eSpark-Backup/simonlore-voiceassistant/README.md

# simonlore-voiceassistant
 This repo will hold all the hardware updates and design progress for the AI Assistant product

## Project Requirements
### User Interaction:
* Home Button: Central command button for basic device activation.
* Voice Recognition Trigger Button: Initiates voice recognition, ensuring user privacy and preventing unintended recordings.
* Rotary Selector: A combination of rotation and press functionality to enable users to navigate and select audio content or other features.

### Audio Interface:
* Input: Advanced voice recognition with three multidirectional microphones.
* Output: Jack port for headphones and Bluetooth audio capability for wireless connection.
* Volume Control: Potentiometer with integrated switch functionality to adjust audio levels.

### Connectivity:
* Wi-Fi Enabled: Facilitates online voice assistant capabilities and connectivity tasks.
* Bluetooth: Enables wireless audio output to headphones or compatible devices.

### Power Management:
* Battery Life: Built to last with up to 10 hours of offline usage and 3+ hours during connected operations.
* Charging Port: A durable USB-C interface (or an alternative based on cost considerations).

### Visual Indicators:
* Status LEDs: Indicators to display power, charging, and connectivity statuses.
* Interactive LEDs: Dynamic luminosity adjustments signal when the device is in listening or speaking mode.

### Operational Modes:
* Online Mode: Provides real-time voice assistance, interactive experiences, and internet-based functions.
* Offline Mode: Grants access to an array of preloaded audio content, ensuring usability without connectivity.

### Content and API Integration:
* Audio Recording: Equipped to record user voice inputs and relay them to an API for processing.
* Audio Playback: Ability to receive and audibly render content, inclusive of voice assistant feedback.
* External API Adaptability: Designed to interface with third-party APIs like Spotify, broadening content accessibility.

### Device Management:
* Remote App Control: A dedicated application to facilitate device setup, manage subscriptions, adjust parameters, and roll out firmware updates.
* Offline Content Administration: The same application enables users to curate offline content for the device.

### Design and Aesthetics:
* Robust Design: Crafted for durability without compromising on visual appeal.
* Safety Protocols: Built-in measures to regulate volume and content, ensuring user safety.

### Expandability and Updates:
* Future Adaptability: The software is designed for updates, ensuring the device remains contemporary with evolving tech trends.
* App-Driven Updates: Provides a user-friendly interface to update the device software and augment content.
