eSpark-Backup/simonlore-voiceassistant/Design-Files/Buttons-Board-v1.0/BOM/Client-BOM-Buttons-Board-v1.0.xlsx

 |  | Component list |  | Bill of Materials for Project [Buttons-Board-v1.0.]
 |  | Source Data From: |  | Buttons-Board-v1.0.
 |  | Project: |  | Buttons-Board-v1.0.
 |  | Variant: |  | None
# | Item Type | Designator | Description | Footprint | Manufacturer Part Number | Manufacturer | Value | Quantity | Quantity (5 Boards) | Remarks | Reviewer Remarks
1 | Capacitor | C1 | CAP CER 10UF 16V X5R 0603 | Cap-0603 | CC0603KRX5R7BB106 | Yageo | 10uF | 1 | 5
2 | Capacitor | C2 | CAP CER 0.1UF 16V X5R 0402 | Cap-0402 | CC0402KRX5R7BB104 | Yageo | 100nF | 1 | 5
3 | Diode | D1, D2, D3, D4, D5, D6, D7, D8, D9, D10, D11, D12 | DIODE GEN PURP 75V 150MA SOD323 | SOD-323 | 1N4148WS-7-F | Diodes | - | 12 | 60
4 | Board / Wire To Wire Connector | J1, J2, J3 | 1x9P 1 Tin 1mm male 9 260℃ -25℃~+85℃ Brass 1A Surface Mount SMD,P=1mm Wire To Board / Wire To Wire Connector ROHS | Custom | X1002WRS-09E-LPSWHF | XKB Connectivity | - | 3 | 15
5 | LED | LED1 | RED LED 0603 Light Emitting Diodes | LED-0603 | NCD0603R3 | Foshan NationStar Optoelectronics | - | 1 | 5
6 | LED | LED2, LED3, LED4, LED5, LED6, LED7, LED8, LED9, LED10, LED11, LED12, LED13, LED14, LED15, LED16, LED17 | blue 0603 Light Emitting Diodes (LED) ROHS | LED-0603 | NCD0603B3 | Foshan NationStar Optoelectronics | - | 16 | 80
7 | Resistor | R1 | RES 1K OHM 1% 1/16W 0402 | Res-0402 | RC0402FR-071KL | Yageo | 1K | 1 | 5
8 | Resistor | R2, R3, R4, R5, R6, R7, R8, R9, R10, R11, R12, R13, R14, R15, R16, R17 | RES 33 OHM 1% 1/20W 0201 | Res-0201 | RC0201FR-0733RL | Yageo | 33R | 16 | 80
9 | Tactile Switch | SW1 | SWITCH TACTILE SPST-NO 0.05A 12V | Custom | TL3300CF160Q | E-Switch | - | 1 | 5
10 | Tactile Switch | SW2, SW3, SW4, SW5, SW6, SW7, SW8, SW9, SW10, SW11, SW12, SW13 | No NO 50mA 100000 Times 160gf 12V Brick nogging SPST SMD Tactile Switches ROHS | Custom | TS-1109S-B-B | XKB Connectivity | - | 12 | 60
