eSpark-Backup/simonlore-voiceassistant/Design-Files/Buttons-Board-v1.0/BOM/eSpark-BOM-Buttons-Board-v1.0.xlsx

 |  | Component list |  | Bill of Materials for Project [Buttons-Board-v1.0.]
 |  | Source Data From: |  | Buttons-Board-v1.0.
 |  | Project: |  | Buttons-Board-v1.0.
 |  | Variant: |  | None
# | Item Type | Designator | Description | Footprint | Manufacturer Part Number | Manufacturer | Alternate Part Number | LCSC Part Number | Value | Quantity | Quantity (5 Boards) | MOQ (5 Boards) | Links | Unit Cost (5 Boards) | Total Cost (5 Boards) | Remarks | Reviewer Remarks
1 | Capacitor | C1 | CAP CER 10UF 16V X5R 0603 | Cap-0603 | CC0603KRX5R7BB106 | Yageo | - | C2936601 | 10uF | 1 | 5 | 10 | LCSC (https://www.lcsc.com/product-detail/Multilayer-Ceramic-Capacitors-MLCC-SMD-SMT_YAGEO-CC0603KRX5R7BB106_C2936601.html) | $0.1372 | $1.3720
2 | Capacitor | C2 | CAP CER 0.1UF 16V X5R 0402 | Cap-0402 | CC0402KRX5R7BB104 | Yageo | - | C106204 | 100nF | 1 | 5 | 100 | LCSC (https://www.lcsc.com/product-detail/Multilayer-Ceramic-Capacitors-MLCC-SMD-SMT_YAGEO-CC0402KRX5R7BB104_C106204.html) | $0.0011 | $0.1100
3 | Diode | D1, D2, D3, D4, D5, D6, D7, D8, D9, D10, D11, D12 | DIODE GEN PURP 75V 150MA SOD323 | SOD-323 | 1N4148WS-7-F | Diodes | - | C60580 | - | 12 | 60 | 100 | LCSC (https://www.lcsc.com/product-detail/Switching-Diode_Diodes-Incorporated-1N4148WS-7-F_C60580.html) | $0.0128 | $1.2800
4 | Board / Wire To Wire Connector | J1, J2, J3 | 1x9P 1 Tin 1mm male 9 260℃ -25℃~+85℃ Brass 1A Surface Mount SMD,P=1mm Wire To Board / Wire To Wire Connector ROHS | Custom | X1002WRS-09E-LPSWHF | XKB Connectivity | - | C437069 | - | 3 | 15 | 20 | LCSC (https://www.lcsc.com/product-detail/Wire-To-Board-Wire-To-Wire-Connector_XKB-Connectivity-X1002WRS-09E-LPSWHF_C437069.html) | $0.1150 | $2.3000
5 | LED | LED1 | RED LED 0603 Light Emitting Diodes | LED-0603 | NCD0603R3 | Foshan NationStar Optoelectronics | - | C3151730 | - | 1 | 5 | 20 | LCSC (https://www.lcsc.com/product-detail/Light-Emitting-Diodes-LED_Foshan-NationStar-Optoelectronics-NCD0603R3_C3151730.html) | $0.0208 | $0.4160
6 | LED | LED2, LED3, LED4, LED5, LED6, LED7, LED8, LED9, LED10, LED11, LED12, LED13, LED14, LED15, LED16, LED17 | blue 0603 Light Emitting Diodes (LED) ROHS | LED-0603 | NCD0603B3 | Foshan NationStar Optoelectronics | - | C158101 | - | 16 | 80 | 100 | LCSC (https://www.lcsc.com/product-detail/Light-Emitting-Diodes-LED_Foshan-NationStar-Optoelectronics-NCD0603B3_C158101.html) | $0.0313 | $3.1300
7 | Resistor | R1 | RES 1K OHM 1% 1/16W 0402 | Res-0402 | RC0402FR-071KL | Yageo | - | C106235 | 1K | 1 | 5 | 100 | LCSC (https://www.lcsc.com/product-detail/Chip-Resistor-Surface-Mount_YAGEO-RC0402FR-071KL_C106235.html) | $0.0007 | $0.0700
8 | Resistor | R2, R3, R4, R5, R6, R7, R8, R9, R10, R11, R12, R13, R14, R15, R16, R17 | RES 33 OHM 1% 1/20W 0201 | Res-0201 | RC0201FR-0733RL | Yageo | - | C295794 | 33R | 16 | 80 | 100 | LCSC (https://www.lcsc.com/product-detail/Chip-Resistor-Surface-Mount_YAGEO-RC0201FR-0733RL_C295794.html) | $0.0009 | $0.0900
9 | Tactile Switch | SW1 | SWITCH TACTILE SPST-NO 0.05A 12V | Custom | TL3300CF160Q | E-Switch | - | C273516 | - | 1 | 5 | 6 | LCSC (https://www.lcsc.com/product-detail/Tactile-Switches_E-Switch-TL3300CF160Q_C273516.html) | $0.4604 | $2.7624
10 | Tactile Switch | SW2, SW3, SW4, SW5, SW6, SW7, SW8, SW9, SW10, SW11, SW12, SW13 | No NO 50mA 100000 Times 160gf 12V Brick nogging SPST SMD Tactile Switches ROHS | Custom | TS-1109S-B-B | XKB Connectivity | - | C480315 | - | 12 | 60 | 80 | LCSC (https://www.lcsc.com/product-detail/Tactile-Switches_XKB-Connectivity-TS-1109S-C-B_C381037.html) | $0.0217 | $1.7360
 |  |  |  |  |  |  |  |  |  |  |  | Total Component Cost |  |  | $13.27
 |  |  |  |  |  |  |  |  |  |  |  | Single Board Cost |  |  | $2.65
