eSpark-Backup/simonlore-voiceassistant/Design-Files/Main-Board-v1.0/BOM/Client-BOM-Main-Board-v1.0.xlsx

 |  | Component list |  | Bill of Materials for Project [Main-Board-v1.0.]
 |  | Source Data From: |  | Main-Board-v1.0.
 |  | Project: |  | Main-Board-v1.0.
 |  | Variant: |  | None
# | Item Type | Designator | Description | Footprint | Manufacturer Part Number | Manufacturer | Value | Quantity | Quantity (5 Boards) | Links | Remarks | Reviewer Remarks
1 | Capacitor | C1, C7, C8, C11, C12, C13, C16, C17, C59, C60, C69, C70, C81, C89, C92 | CAP CER 10UF 16V X5R 0603 | Cap-0603 | CC0603KRX5R7BB106 | Yageo | 10uF | 15 | 75
2 | Capacitor | C2 | CAP CER 10000PF 50V C0G/NPO 0603 | Cap-0603 | CC0603JRNPO9BN103 | Yageo | 10nF | 1 | 5
3 | Capacitor | C3, C19, C20, C51, C52 | CAP CER 22UF 16V X5R 0805 | Cap-0805 | CL21A226MOCLRNC | Samsung | 22uF | 5 | 25
4 | Capacitor |  | CAP CER 0.1UF 16V X5R 0402 | Cap-0402 | CC0402KRX5R7BB104 | Yageo | 100nF | 39 | 195
5 | Capacitor | C6 | CAP CER 22UF 10V X5R 0603 | Cap-0603 | CC0603MRX5R6BB226 | Yageo | 22uF | 1 | 5
6 | Capacitor | C10, C22 | CAP TANT 100UF 20% 25V 2917 | Case-E | TAJE107M025RNJ | Kyocera AVX | 100uF | 2 | 10
7 | Capacitor | C18 | CAP CER 4700PF 1KV X7R 1206 | Cap-1206 | CC1206KKX7RCBB472 | Yageo | 4.7nF | 1 | 5
8 | Capacitor | C42, C43 | CAP CER 18PF 50V C0G/NPO 0603 | Cap-0603 | CC0603JRNPO9BN180 | Yageo | 18pF | 2 | 10
9 | Capacitor | C45, C47, C48, C49, C50, C61, C62, C67, C68, C83, C84, C85, C93 | CAP CER 1UF 25V X5R 0402 | Cap-0402 | CC0402KRX5R8BB105 | Yageo | 1uF | 13 | 65
10 | Capacitor | C55, C56, C79, C80 | CAP CER 39PF 50V C0G/NPO 0402 | Cap-0402 | CC0402FRNPO9BN390 | Yageo | 39pF | 4 | 20
11 | Capacitor | C57, C58, C71, C72 | 470uF 16V ±20% SMD,D6.3xL7.7mm Aluminum Electrolytic Capacitors - SMD ROHS | Custom | RVT1C471M0607 | ROQANG | 470uF | 4 | 20
12 | Capacitor | C63, C64 | CAP CER 1000PF 25V C0G/NPO 0603 | CAP-0603 | CC0603JRNPO8BN102 | Yageo | 1nF | 2 | 10
13 | Capacitor | C65, C66 | CAP CER 3300PF 50V C0G/NPO 0603 | Cap-0603 | CC0603JRNPO9BN332 | Yageo | 3.3nF | 2 | 10
14 | Capacitor | C75, C76, C77, C78 | CAP CER 330PF 50V C0G/NPO 0603 | Cap-0603 | CC0603JRNPO9BN331 | Yageo | 330pF | 4 | 20
15 | Capacitor | C95 | CAP CER 0.22UF 25V X5R 0402 | Cap-0402 | CC0402KRX5R8BB224 | Yageo | 220nF | 1 | 5
16 | Diode | D1 | SOD-523 ESD Protection Devices ROHS | SOD-523 | LESD5D5.0CT1G | UMW | - | 1 | 5
17 | Diode | D2 | DIODE SCHOTTKY 40V 1A SOD123 | SOD-123 | 1N5819HW-7-F | Diodes | - | 1 | 5
18 | Diode | D3, D4 | 0.5mA@40V 40V Single 3A 0.55V@3A SMA(DO-214AC) Schottky Barrier Diodes (SBD) ROHS | SMA | SS34 | MDD | - | 2 | 10
19 | Diode | D5, D6, D7, D8, D9, D10, D11 | 5V 10V 3.3V Bi-Directional SOD-882 ESD Protection Devices ROHS | SOD-882 | LESD8D3.3CAT5G | LRC | - | 7 | 35
20 | Ferrite Bead | FB1, FB3, FB4, FB5, FB6, FB7, FB8, FB9, FB10 | FERRITE BEAD 120 OHM 0603 1LN | IND-0603 (1608 Metric) | BLM18SG121TZ1D | Murata | - | 9 | 45
21 | Ferrite Bead | FB2 | FERRITE BEAD 120 OHM 1206 1LN | IND-1206 | BLM31KN121SZ1L | Murata | - | 1 | 5
22 | USB Connector | J1 | USB 3.1 1 Surface Mount 6 Female -25℃~+85℃ Type-C SMD USB Connectors ROHS | Custom | U262-061N-4BVC11 | XKB | - | 1 | 5
23 | Right Angle JST | J2, J6, J7 | 1x2P 1 2mm Male pin 2 -25℃~+85℃ 2A Surface Mount SMD,P=2mm Wire To Board / Wire To Wire Connector ROHS | Custom | WAFER-PH2.0-2PWB | XUNPU | - | 3 | 15
24 | Connector | J3 | 1x6P SH 1 1mm 6 SMD,P=1mm Wire To Board / Wire To Wire Connector ROHS | Custom | C145963 | BOOMELE | - | 1 | 5
25 | Male Header | J4 | Gold 250V 3A Straight Square Pins 2.5mm 2P 260℃ 6mm -40℃~+105℃ 3mm 2.54mm Plugin Black Brass 1x2P Plugin,P=2.54mm Pin Headers ROHS | Custom | X6511WV-02H-C60D30 | XKB | - | 1 | 5
26 | Connector | J5 | -20℃~+70℃ 3.5mm headphone jack 235℃ 12V 0.5A SMD Audio Connectors ROHS | Custom | PJ-342B-TX-SMT | XKB Connectivity | - | 1 | 5
27 | SD Card Connector | J8 | CONN MICRO SD CARD PUSH-PUSH R/A | Custom | DM3BT-DSF-PEJS | Hirose | - | 1 | 5
28 | Board / Wire To Wire Connector | J9, J10, J11 | 1x9P 1 Tin 1mm male 9 260℃ -25℃~+85℃ Brass 1A Surface Mount SMD,P=1mm Wire To Board / Wire To Wire Connector ROHS | Custom | X1002WRS-09E-LPSWHF | XKB Connectivity | - | 3 | 15
29 | Inductor | L1, L2, L3 | 4.5A 4.7uH ±20% SMD,10.1x10.1mm Power Inductors ROHS | Custom | YSLF1045-4R7M | YJYCOIN | 4.7uH | 3 | 15
30 | Inductor | L4, L5, L6, L7 | 3.6A 33uH Shielded Power Inductors ±20% 4.25A SMD,12.5x12.5mm Power Inductors ROHS | Custom | SMDRI129-330MT | SXN | 33uH | 4 | 20
31 | LED | LED1, LED3 | RED LED 0603 Light Emitting Diodes | LED-0603 | NCD0603R3 | Foshan NationStar Optoelectronics | - | 2 | 10
32 | LED | LED2 | Emerald 0603 Light Emitting Diodes (LED) ROHS | LED-0603 | NCD0603G2 | Foshan NationStar Optoelectronics | - | 1 | 5
33 | TEST POINT | ~~P1, P2, P3, P4, P5, P6, P7, P8, P9, P10, P11, P12, P13, P14, P15, P16, P17, P18, P19, P20, P21, P22, P23, P24, P25, P26, P27~~ | ~~Test Point ON~~ | ~~Custom~~ | ~~Test-point~~ | ~~-~~ | ~~-~~ | ~~27~~ | ~~135~~
34 | MOSFET | Q1, Q2 | MOSFET P-CH 12V 16A 8SO | SOP-8 | IRF7410TRPBF | Infineon | - | 2 | 10
35 | MOSFET | Q3 | 25V 300mW 120@100mA,1V 1.5A NPN SOT-23 Bipolar Transistors - BJT ROHS | SOT-23 | SS8050-G | Jiangsu Changjing Electronics Technology | - | 1 | 5
36 | MOSFET | Q4, Q5 | 50V 0.2A 225mW 3.5Ω@5V,200mA N Channel SOT-23 MOSFETs ROHS | SOT-23 | LBSS138LT1G | LRC | - | 2 | 10
37 | Resistor | R1, R2, R28, R36, R72, R73, R74, R89, R90, R91, R92, R148 | RES 100K OHM 1% 1/16W 0402 | Res-0402 | RC0402FR-07100KL | Yageo | 100K | 12 | 60
38 | Resistor | R3 | 2W Thick Film Resistors ±200ppm/℃ ±1% 0Ω 2512 Chip Resistor - Surface Mount ROHS | RES-2512 | FRP2512F0000TS | FOJAN | 0R | 1 | 5
39 | Resistor | R4, R6, R7, R15, R16, R26, R27, R31, R38, R66, R68, R69, R70, R71, R129, R130, R131, R132, R133, R134, R135, R137, R139, R144, R145 | RES 10K OHM 1% 1/16W 0402 | Res-0402 | RC0402FR-0710KL | Yageo | 10K | 25 | 125
40 | Resistor | R5, R17 | RES 0 OHM JUMPER 1/16W 0402 | Res-0402 | RC0402FR-070RL | Yageo | 0R | 2 | 10
41 | Resistor | R8, R18, R146 | RES SMD 52.3KOHM 0.1% 1/16W 0402 | Res-0402 | RT0402BRD0752K3L | Yageo | 52.3K | 3 | 15
42 | Resistor | R9, R19, R147 | RES SMD 30.1KOHM 0.1% 1/16W 0402 | Res-0402 | RT0402BRD0730K1L | Yageo | 30.1K | 3 | 15
43 | Resistor | R10, R23, R29, R39, R40 | RES 1K OHM 1% 1/16W 0402 | Res-0402 | RC0402FR-071KL | Yageo | 1K | 5 | 25
44 | Resistor | R11, R12, R13, R14 | RES 0 OHM JUMPER 1/8W 0805 | Res-0805 | RC0805FR-070RL | Yageo | 0R | 4 | 20
45 | Resistor | R20, R21 | RES 5.1K OHM 1% 1/16W 0402 | Res-0402 | RC0402FR-075K1L | Yageo | 5.1K | 2 | 10
46 | Resistor | R22 | RES SMD 1M OHM 1% 1/10W 0603 | Res-0603 | RC0603FR-071ML | Yageo | 1M | 1 | 5
47 | Resistor | R24 | RES SMD 316 OHM 0.1% 1/8W 0805 | RES-0805 | RT0805BRD07316RL | Yageo | 316R | 1 | 5
48 | Resistor | R25 | RES 1K OHM 1% 1/8W 0805 | RES-0805 | RC0805FR-071KL | Yageo | 1K | 1 | 5
49 | Resistor | R30, R32, R33, R34, R37, R41, R42, R43, R44, R45, R46, R47, R48, R49, R50, R51, R52, R53, R54, R55, R56, R57, R58, R59, R60, R61, R62, R63, R64, R65, R67 | RES SMD 0 OHM JUMPER 1/20W 0201 | Res-0201 | RC0201JR-070RL | Yageo | 0R | 31 | 155
50 | Resistor | R35, R112, R113, R114, R116 | RES 0 OHM JUMPER 1/10W 0603 | Res-0603 | RC0603JR-070RL | Yageo | 0R | 5 | 25
51 | Resistor | R75, R76, R77, R78, R79, R80, R81, R82, R83, R84, R85, R86, R87, R88, R93, R94, R95, R96, R97, R98, R99, R100, R101, R102, R103, R104, R105, R106, R107, R108, R136, R138, R140, R141, R142, R143 | RES 33 OHM 1% 1/20W 0201 | Res-0201 | RC0201FR-0733RL | Yageo | 33R | 36 | 180
52 | Resistor | R109 | RES 3.3K OHM 1% 1/20W 0201 | Res-0201 | RC0201FR-073K3L | Yageo | 3.3K | 1 | 5
53 | Resistor | R110, R111 | RES 56K OHM 1% 1/16W 0402 | Res-0402 | RC0402FR-0756KL | Yageo | 56k | 2 | 10
54 | Resistor | R115 | RES 22.1K OHM 1% 1/10W 0603 | Res-0603 | RC0603FR-0722K1L | Yageo | 22.1K | 1 | 5
55 | Resistor | R117, R128 | RES 1K OHM 1% 1/16W 0402 | Res-0402 | RC0402FR-071KL | Yageo | DNP | 2 | 10 |  | DO NOT Place
56 | Resistor | R118, R119 | RES 1 OHM 1% 1/10W 0603 | Res-0603 | RC0603FR-071RL | Yageo | 1R | 2 | 10
57 | Resistor | R120 | RES SMD 18K OHM 0.1% 1/16W 0402 | Res-0402 | RT0402BRD0718KL | Yageo | 18K | 1 | 5
58 | Resistor | R121 | RES SMD 28K OHM 0.1% 1/16W 0402 | Res-0402 | RT0402BRD0728KL | Yageo | 28K | 1 | 5
59 | Resistor | R122, R124 | RES SMD 510K OHM 0.1% 1/10W 0603 | Res-0603 | RT0603BRD07510KL | Yageo | 510K | 2 | 10
60 | Resistor | R123, R125 | RES SMD 110K OHM 0.1% 1/10W 0603 | Res-0603 | RT0603BRE07110KL | Yageo | 110K | 2 | 10
61 | Resistor | R126, R127 | RES 30K OHM 1% 1/16W 0402 | Res-0402 | RC0402FR-0730KL | Yageo | 30K | 2 | 10
62 | Solder Bridge | SB1 | Solder Bridge ON | Custom | Solder Bridge 0402 | - | - | 1 | 5 |  | DO NOT Place
63 | Switch | SW1, SW2 | No NO 50mA 4.5mm 100000 260gf 12V -30℃~+85℃ 4.5mm 4.3mm Black Round Button Brick nogging SPST SMD Tactile Switches ROHS | Custom | TS-1109S-C-B | XKB Connectivity | - | 2 | 10
64 | IC | U1 | IC REG LINEAR 3.3V 1A SOT223-6 | SOT-223-6_ | TPS79633DCQR | Texas Instruments | - | 1 | 5
65 | IC | U2 | IC CNTRLR ON/OFF W/DEB TSOT23-6 | TSOT-23-6 | MAX16054AZT+T | Maxim | - | 1 | 5
66 | IC | U3, U4, U5, U16 | IC REG LIN POS ADJ 400MA SOT23-5 | SOT-23-5 | TPS73601DBVR | Texas Instruments | - | 4 | 20
67 | IC | U6 | 4V~6V Polymer 1 3.5A SOP-8-EP Battery Management ICs ROHS | 8-SO-EP_ | SLM6600 | SOLA-IC | - | 1 | 5
68 | IC | U7 | IC SUPERVISOR 1 CHANNEL SOT23-3 | SOT-23 | CAT809RTBI-GT3 | ON Semiconductor | - | 1 | 5
69 | Module | U8 | RF TXRX MODULE BT PCB TRACE SMD | 38-SMD Module | ESP32-WROVER-E-N16R8 | Espressif Systems | - | 1 | 5
70 | IC | U9 | IC AUDIO SIGNAL PROCESSOR 64QFN | QFN-64-EP(9x9) | ZL38063LDG1 | Microchip | - | 1 | 5
71 | IC | U10 | IC FLASH 16MBIT SPI/QUAD 8SOIC | SOP-8 | W25Q16JVSNIQ | Winbond | - | 1 | 5
72 | IC | U11, U12 | SOP8L-PP Audio Power OpAmps ROHS | 8-SO-EP_ | HT8691RSPER | Jiaxing Heroic Elec Tech | - | 2 | 10
73 | Microphone | U13, U14, U15 | MIC MEMS DIGITAL PDM OMNI -26DB | Custom | MP34DT06JTR | STMicroelectronics | - | 3 | 15
74 | IC | U17 | IC XPNDR 100KHZ I2C 20TSSOP | TSSOP-20 | PCF8574APWR | Texas Instruments | - | 1 | 5
75 | IC | U18 | IC LED DRVR LIN PWM 20MA 28QFN | QFN-28-EP(4x4) | IS31FL3216A-QFLS3-TR | ISSI | - | 1 | 5
76 | Crystal | X1 | 12MHz 18pF ±10ppm SMD2520-4P Crystals ROHS | Custom | 2TJ412000XYGBC | JYJE | 12MHz | 1 | 5
77 | Peripheral | - | Polymer lithium battery, 906090 mobile power charging treasure | - | Battery | - | - | 1 | 5 | Aliexpress (https://vi.aliexpress.com/item/32824237225.html?gatewayAdapt=glo2vnm)
78 | Peripheral |  |  |  | Speaker
