eSpark-Backup/simonlore-voiceassistant/Design-Files/Main-Board-v1.0/Main-Board-v1.0.pdf

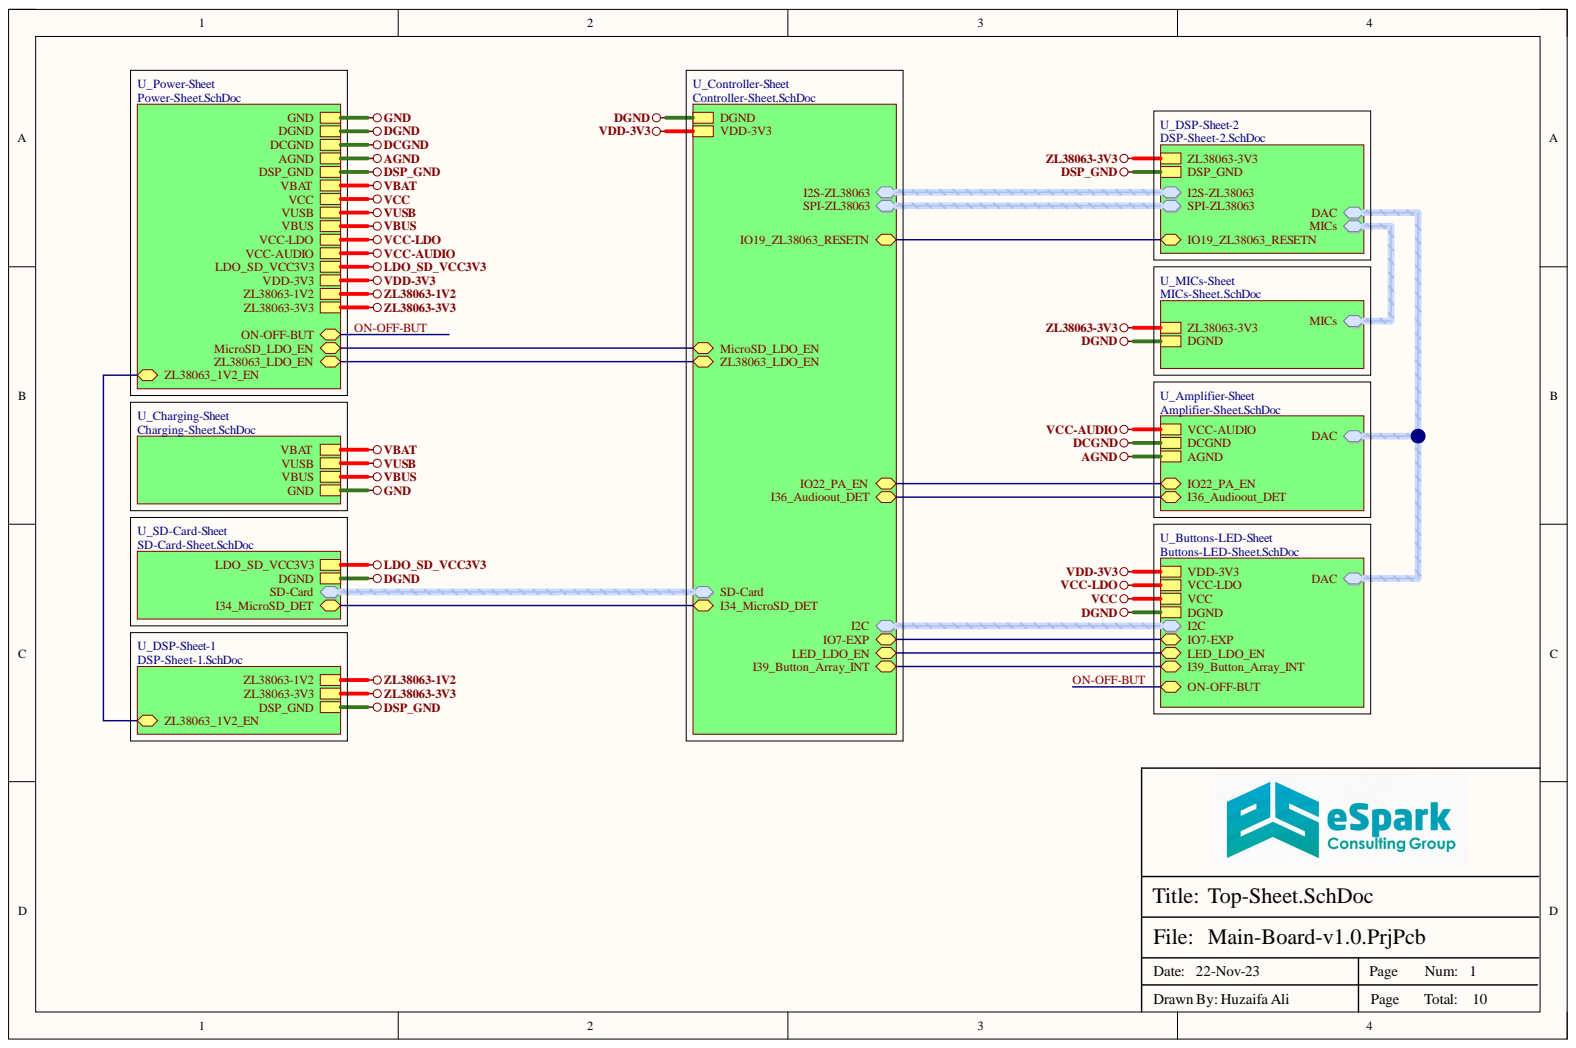
[picture p1: page 1]

U_SD-Card-Sheet
SD-Card-Sheet.SchDoc

Date: 22-Nov-23 | Page Num: 1

Drawn By: Huzaifa Ali | Page Total: 10

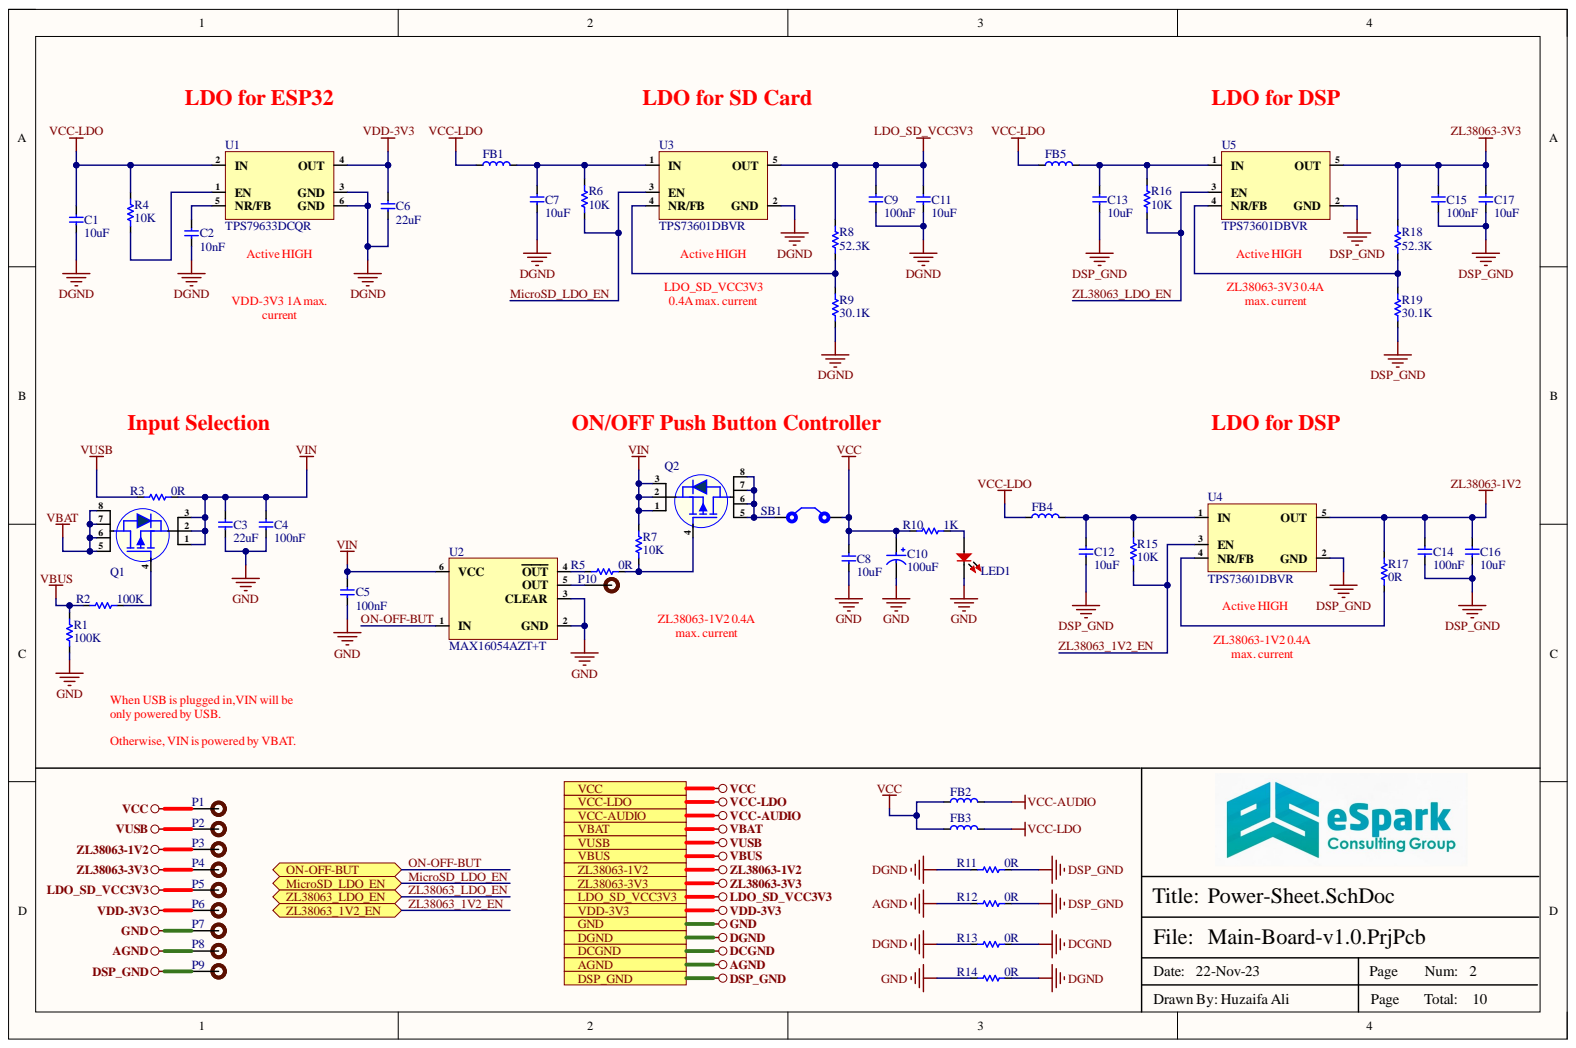
[picture p2: page 2]

LDO for SD Card

When USB is plugged in,VIN will be
only powered by USB.

Otherwise, VIN is powered by VBAT.

Date: 22-Nov-23 | Page Num: 2

Drawn By: Huzaifa Ali | Page Total: 10

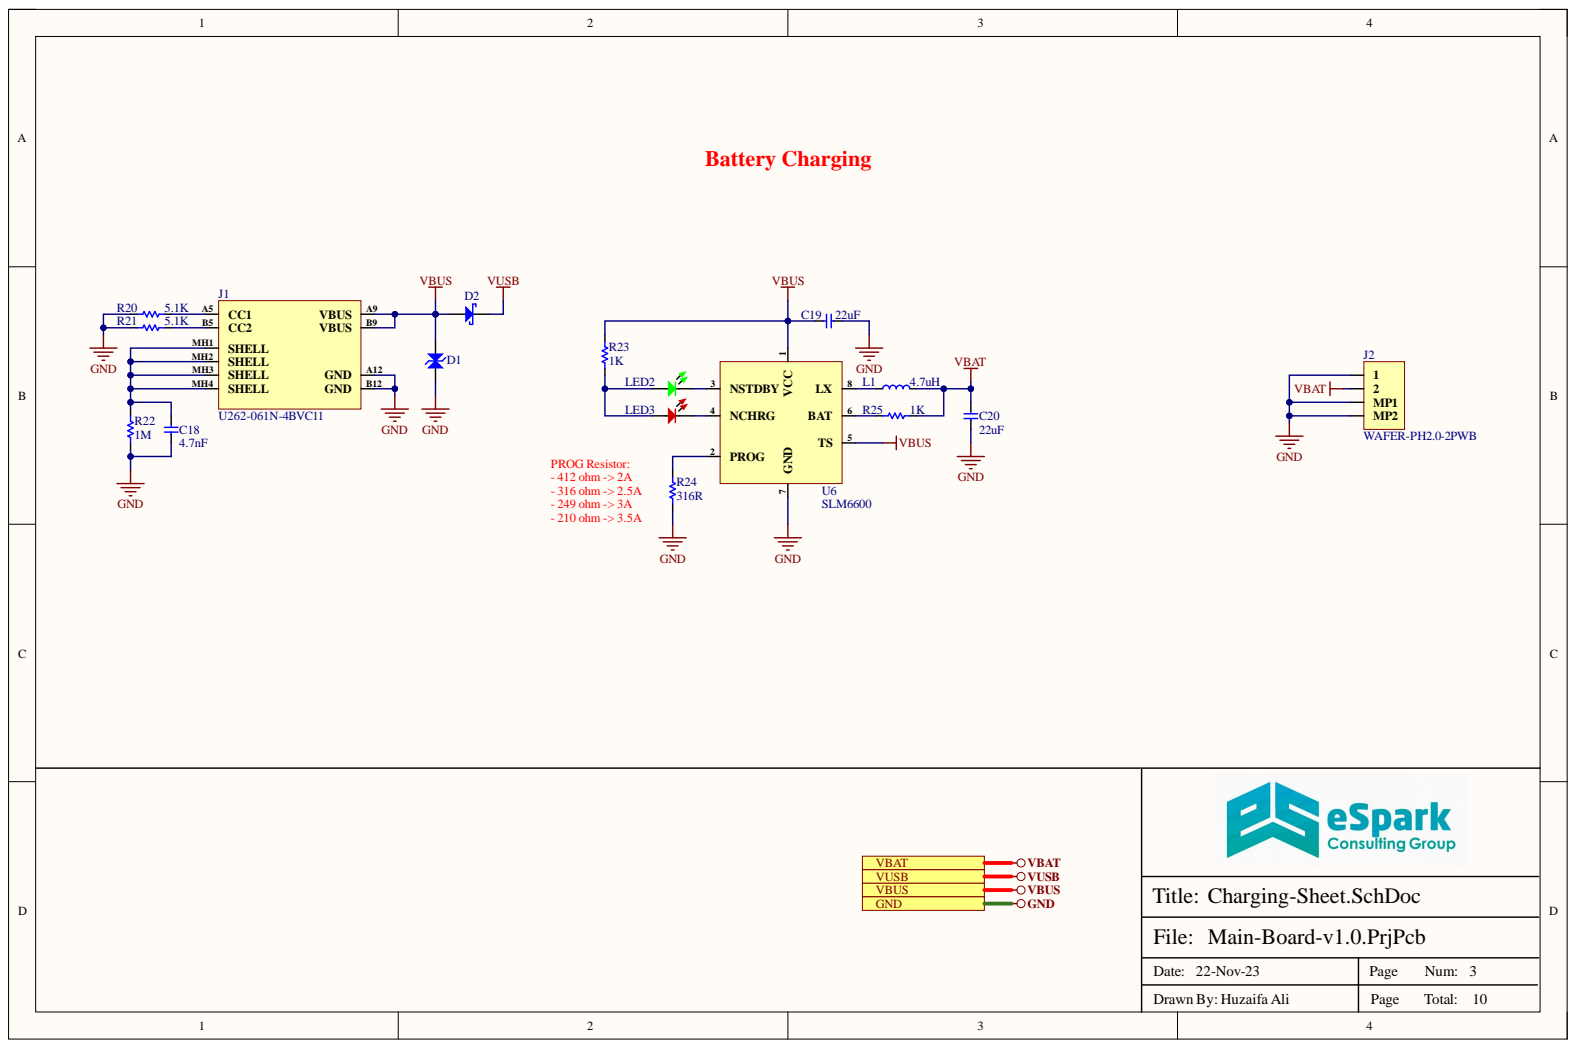
[picture p3: page 3]

Date: 22-Nov-23 | Page Num: 3

Drawn By: Huzaifa Ali | Page Total: 10

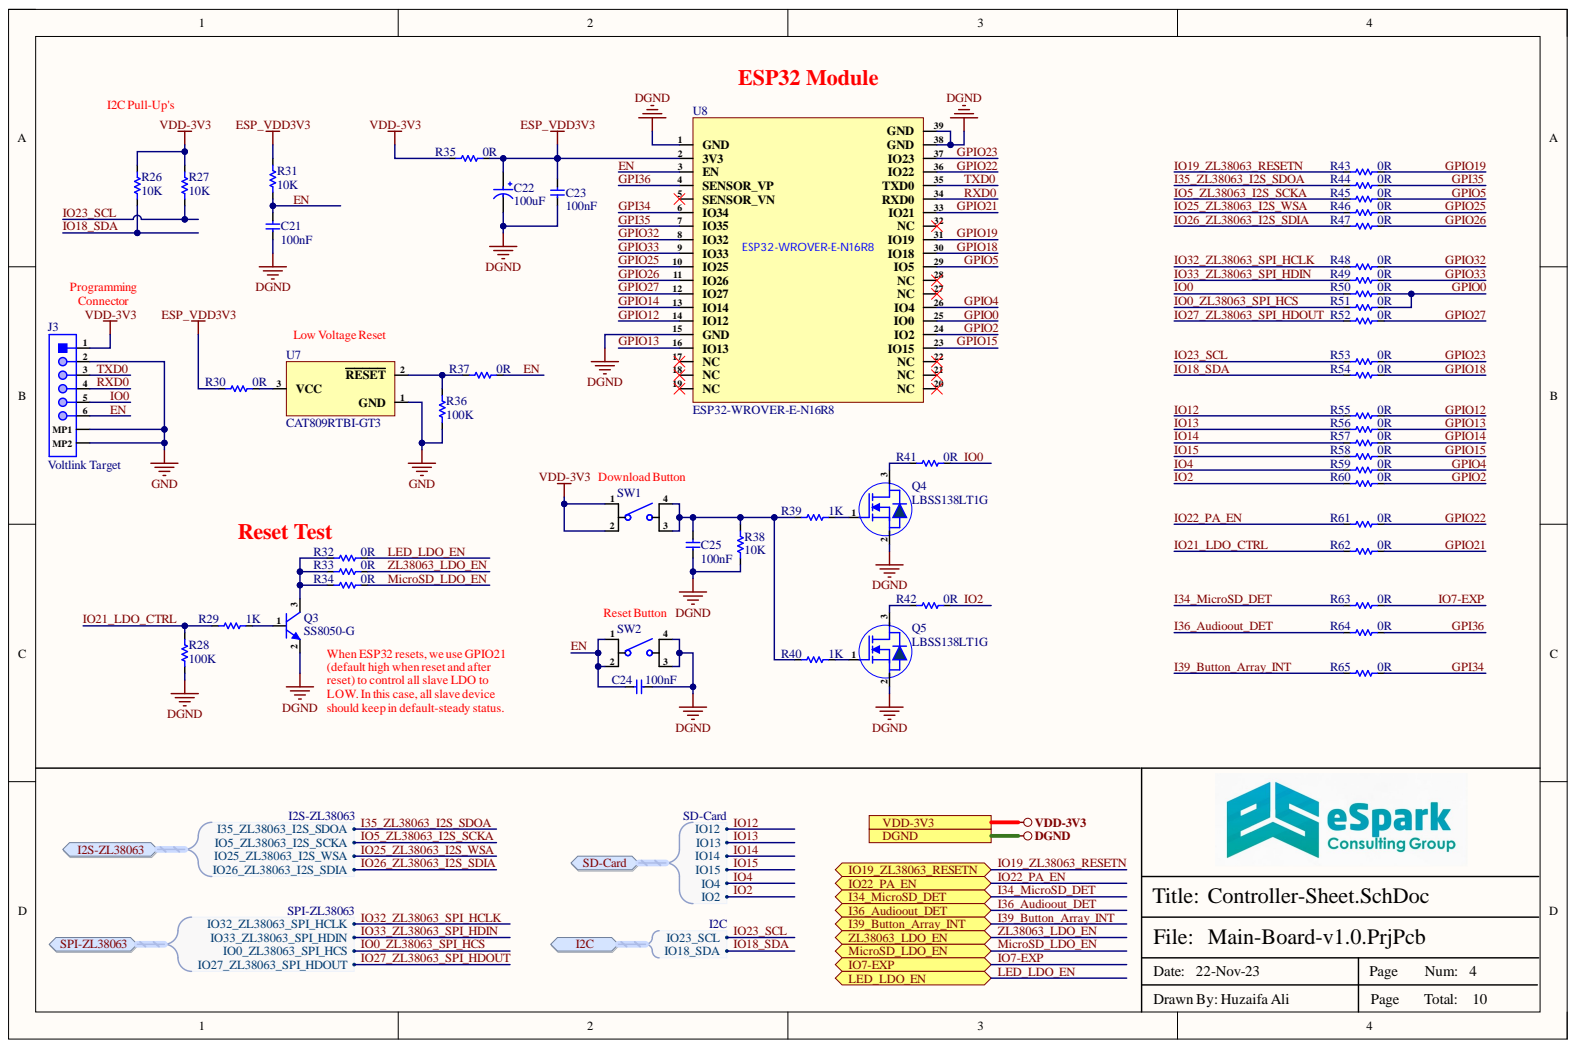
[picture p4: page 4]

esets, we use GP
eset

Dat e : 2 2 -N o v -2 3 | Pag e N u m : 41

D raw n B y : H uzai fa A l i | Pag e To t al : 0

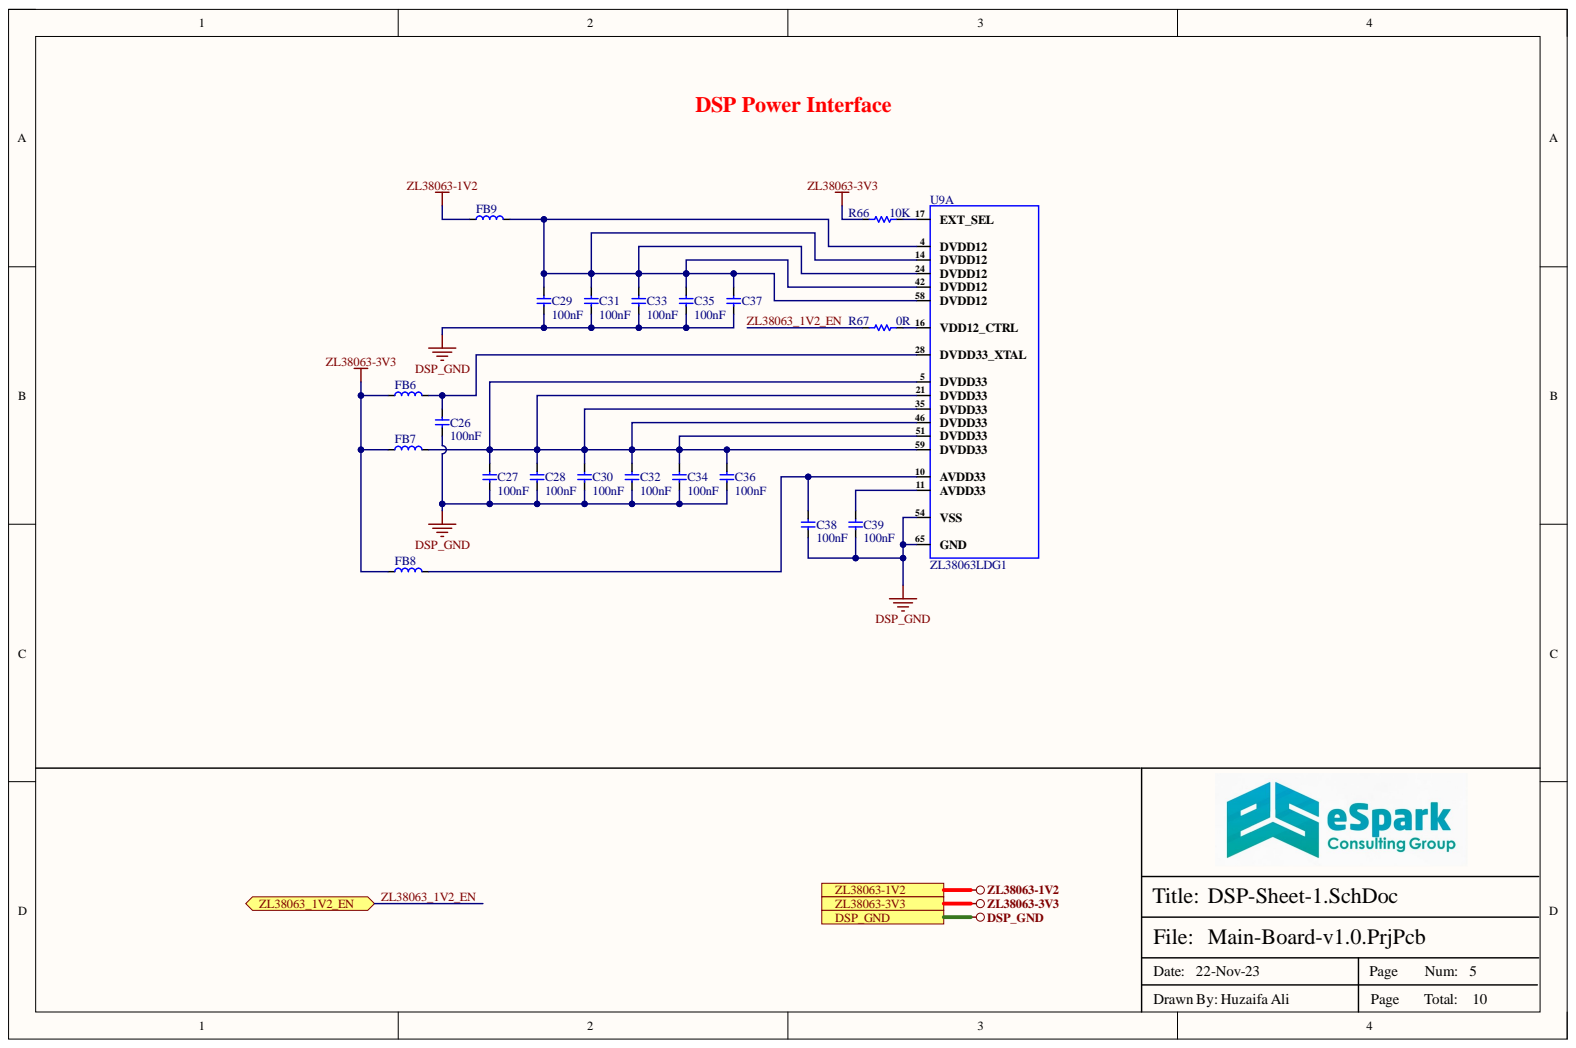
[picture p5: page 5]

Date: 22-Nov-23 | Page Num: 5

Drawn By: Huzaifa Ali | Page Total: 10

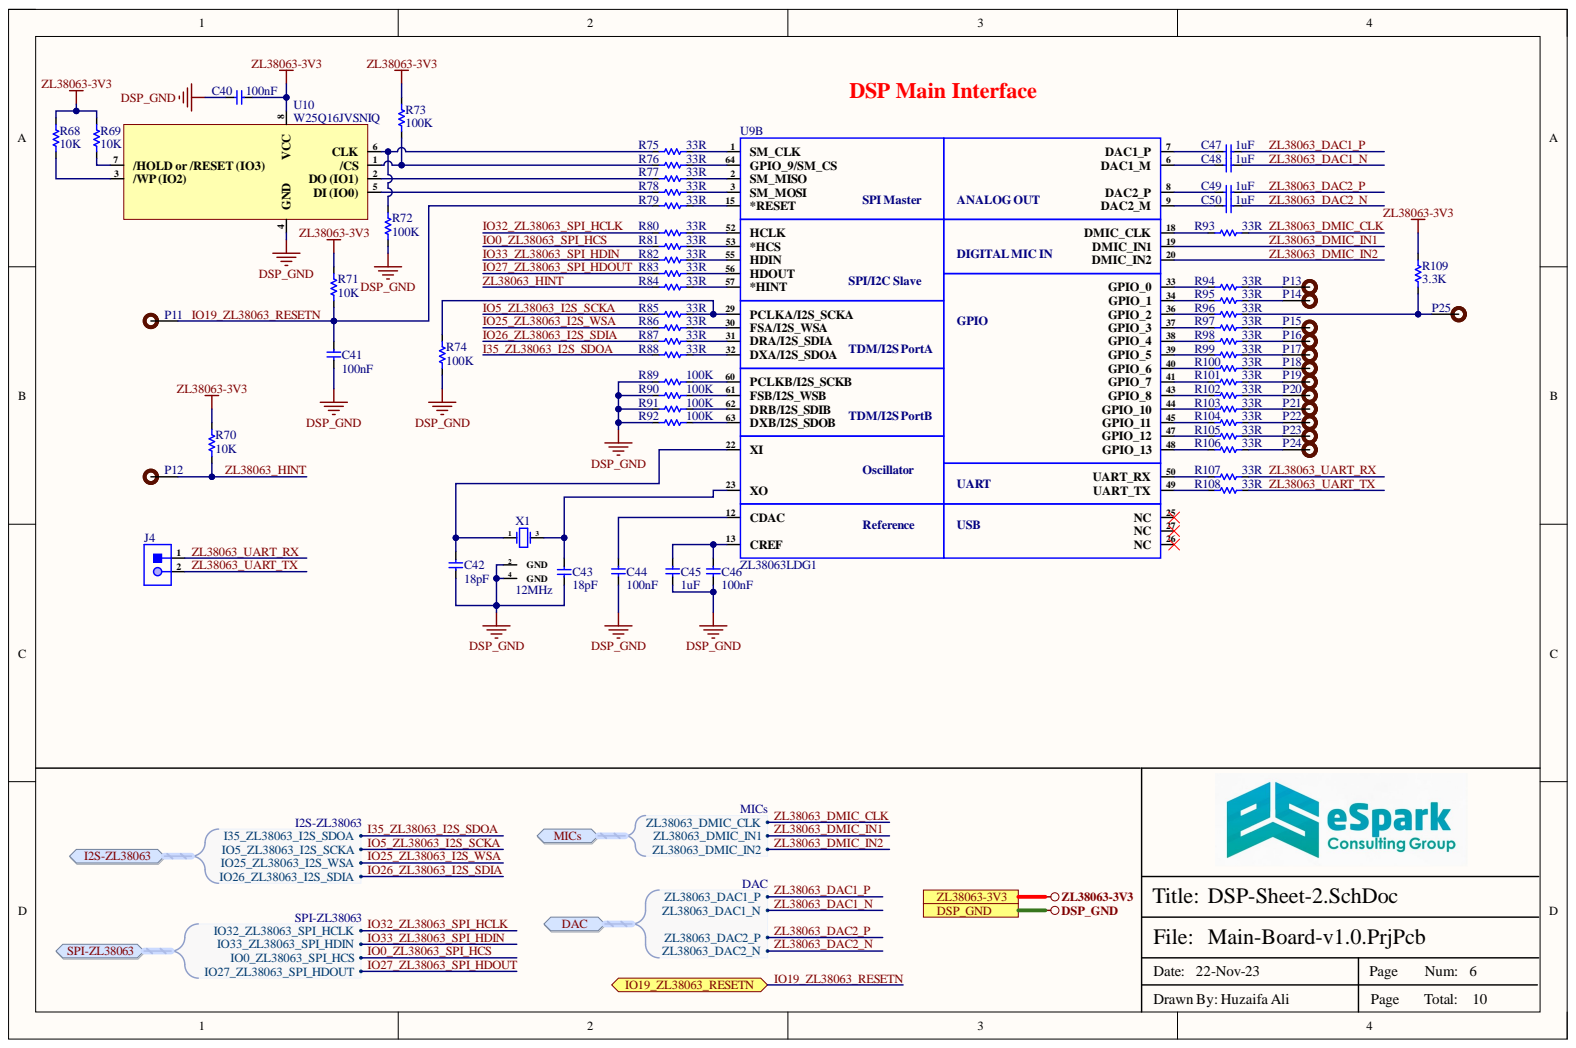
[picture p6: page 6]

MICs ZL38063_DMIC_CLK I2S-ZL38063 ZL38063_DMIC_CLK I35_ZL38063_I2S_SDOA ZL38063_DMIC_IN1 I35_ZL38063_I2S_SDOA MICs ZL38063_DMIC_IN1 IO5_ZL38063_I2S_SCKA ZL38063_DMIC_IN2 IO5_ZL38063_I2S_SCKA ZL38063_DMIC_IN2 I2S-ZL38063 IO25_ZL38063_I2S_WSA IO25_ZL38063_I2S_WSA IO26_ZL38063_I2S_SDIA IO26_ZL38063_I2S_SDIA DAC IO32_ZL38063_SPI_HCLK DAC IO32_ZL38063_SPI_HCLK ZL38063_DAC2_P IO33_ZL38063_SPI_HDIN ZL38063_DAC2_P IO33_ZL38063_SPI_HDIN ZL38063_DAC2_N SPI-ZL38063 IO0_ZL38063_SPI_HCS ZL38063_DAC2_N IO0_ZL38063_SPI_HCS IO27_ZL38063_SPI_HDOUT IO27_ZL38063_SPI_HDOUT IO19_ZL38063_RESETN IO19_ZL38063_RESETN

Date: 22-Nov-23 | Page Num: 6

Drawn By: Huzaifa Ali | Page Total: 10

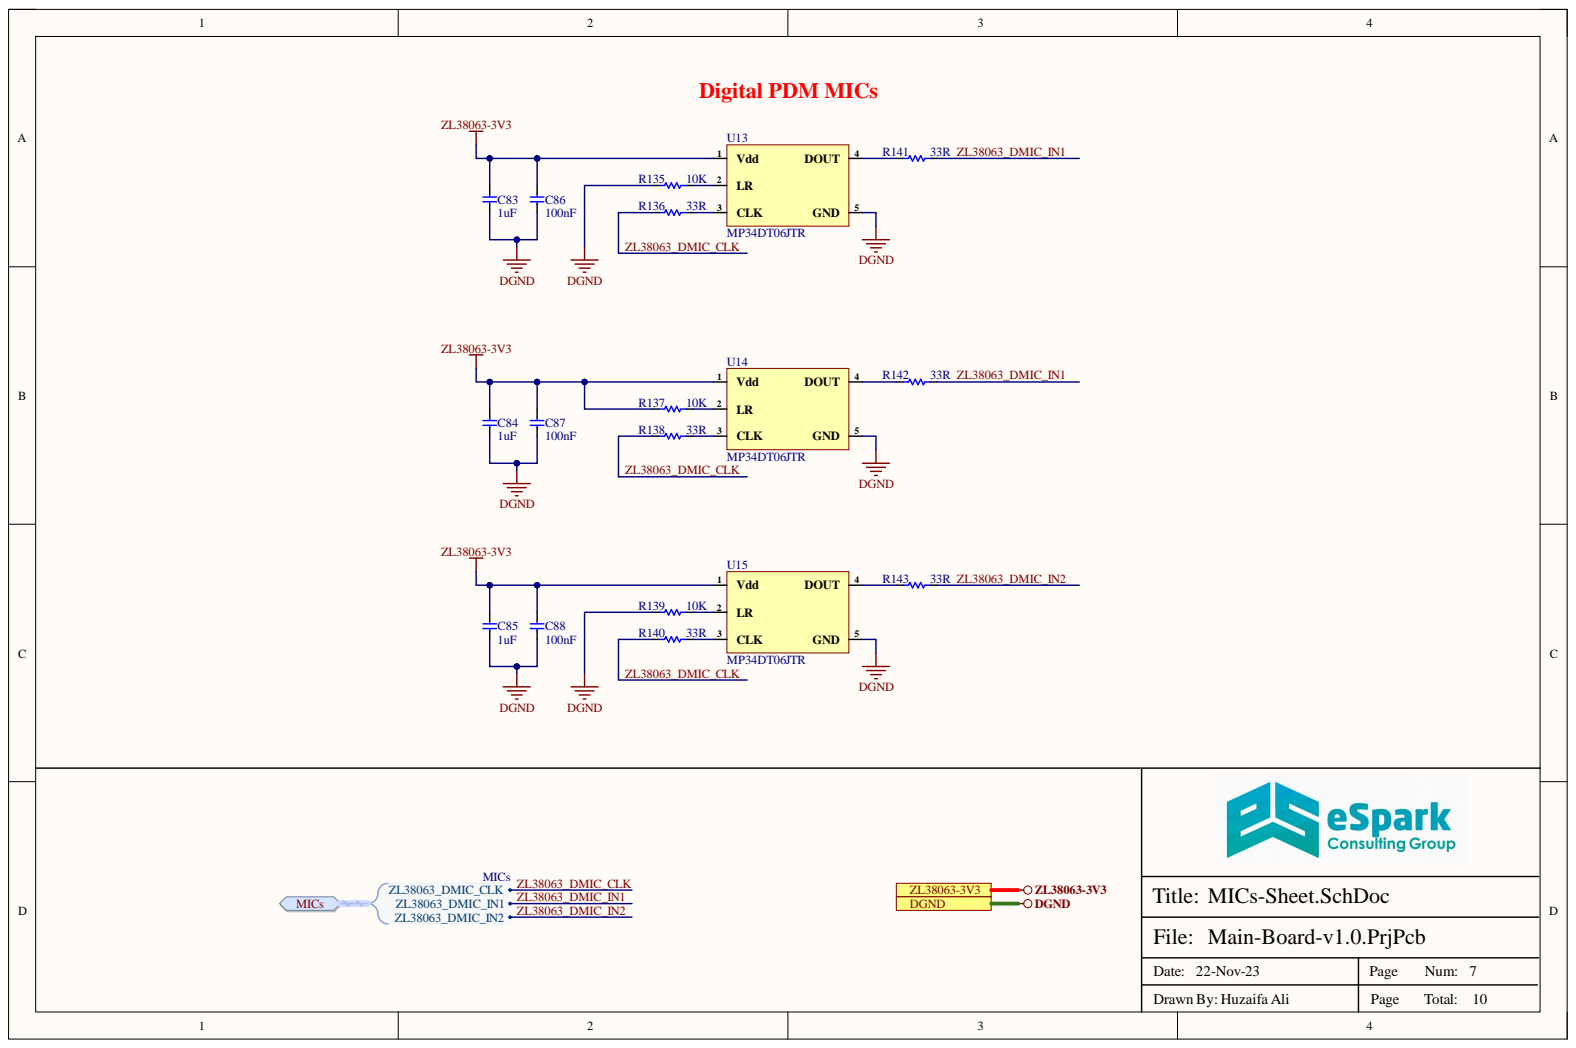
[picture p7: page 7]

MICs ZL38063_DMIC_IN2

Date: 22-Nov-23 | Page Num: 7

Drawn By: Huzaifa Ali | Page Total: 10

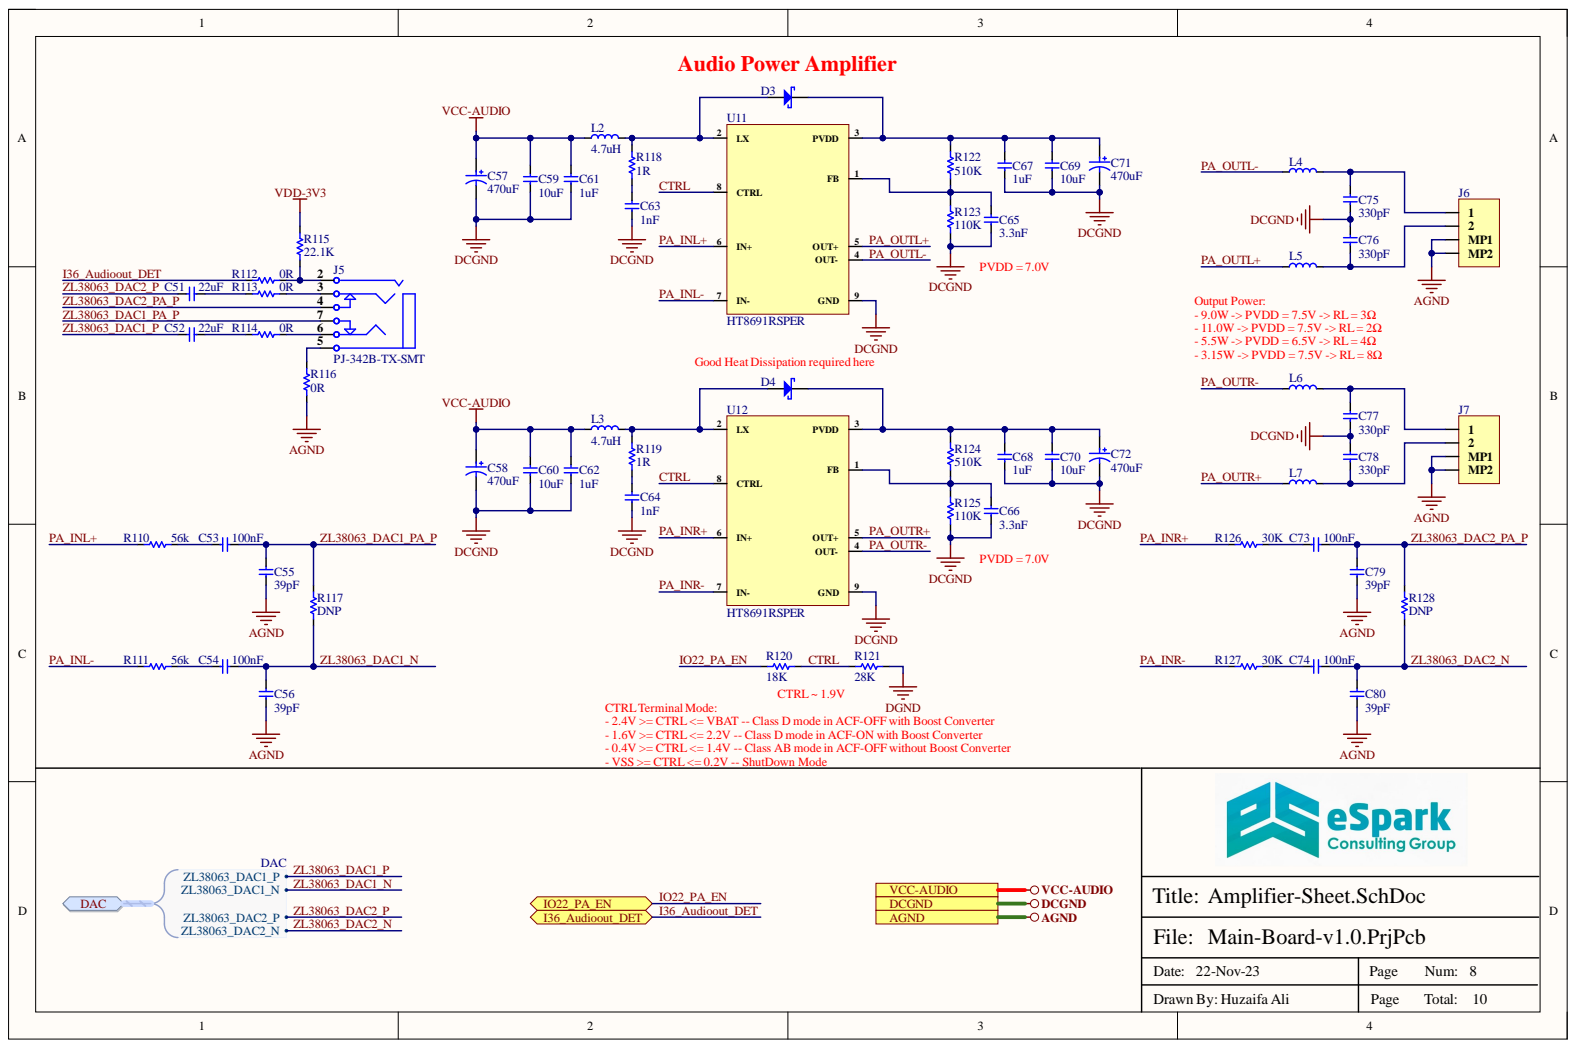
[picture p8: page 8]

Good Heat Dissipation required here

CTRLTerminal Mode:
- 2.4V >= CTRL <= VBAT -- Class D mode in ACF-OFF with Boost Converter
- 1.6V >= CTRL <= 2.2V -- Class D mode in ACF-ON with Boost Converter
- 0.4V >= CTRL <= 1.4V -- Class AB mode in ACF-OFF without Boost Converter
- VSS >= CTRL <= 0.2V -- ShutDown Mode

DAC ZL38063_DAC1_P ZL38063_DAC1_P ZL38063_DAC2_N

Date: 22-Nov-23 | Page Num: 8

Drawn By: Huzaifa Ali | Page Total: 10

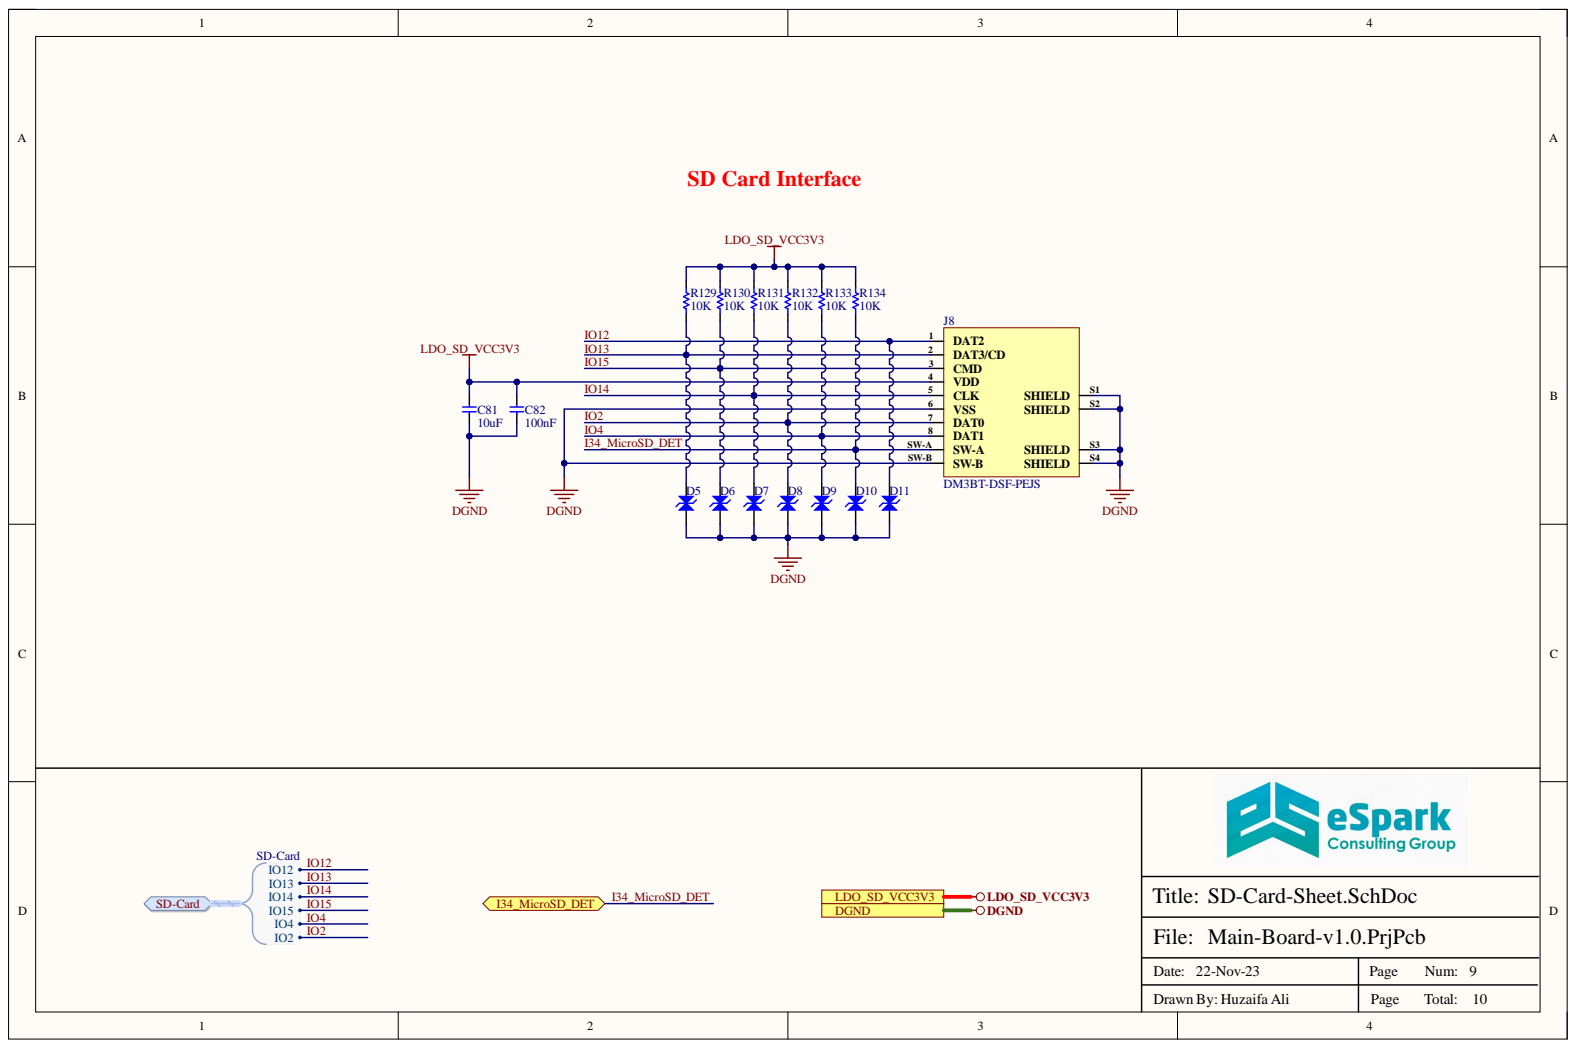
[picture p9: page 9]

SD-Card IO12 IO12 IO2

SD-Card-Sheet.SchDoc

Date: 22-Nov-23 | Page Num: 9

Drawn By: Huzaifa Ali | Page Total: 10

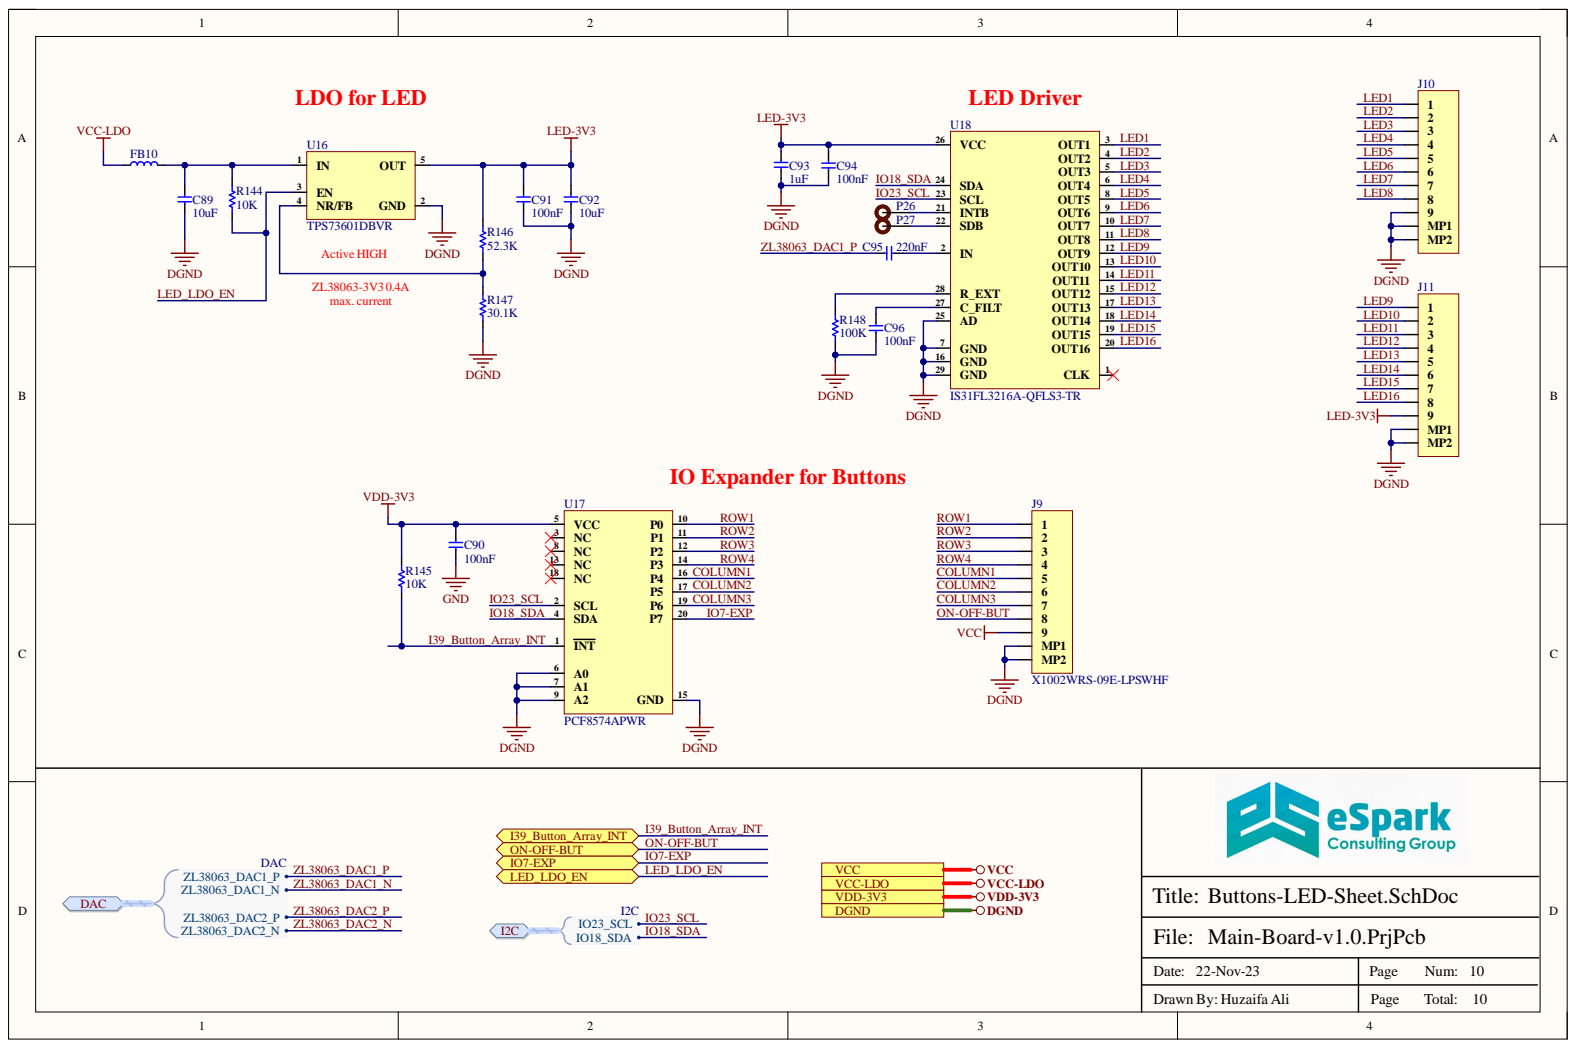
[picture p10: page 10]

IO Expander for Buttons

I39_Button_Array_INT I39_Button_Array_INT ON-OFF-BUT ON-OFF-BUT IO7-EXP IO7-EXP ZL38063_DAC2_N IO23_SCL ZL38063_DAC2_N I2C IO18_SDA IO18_SDA

Buttons-LED-Sheet.SchDoc

Date: 22-Nov-23 | Page Num: 10

Drawn By: Huzaifa Ali | Page Total: 10
