eSpark-Backup/simonlore-voiceassistant/Design-Files/Buttons-Board-v1.0/Buttons-Board-v1.0.pdf

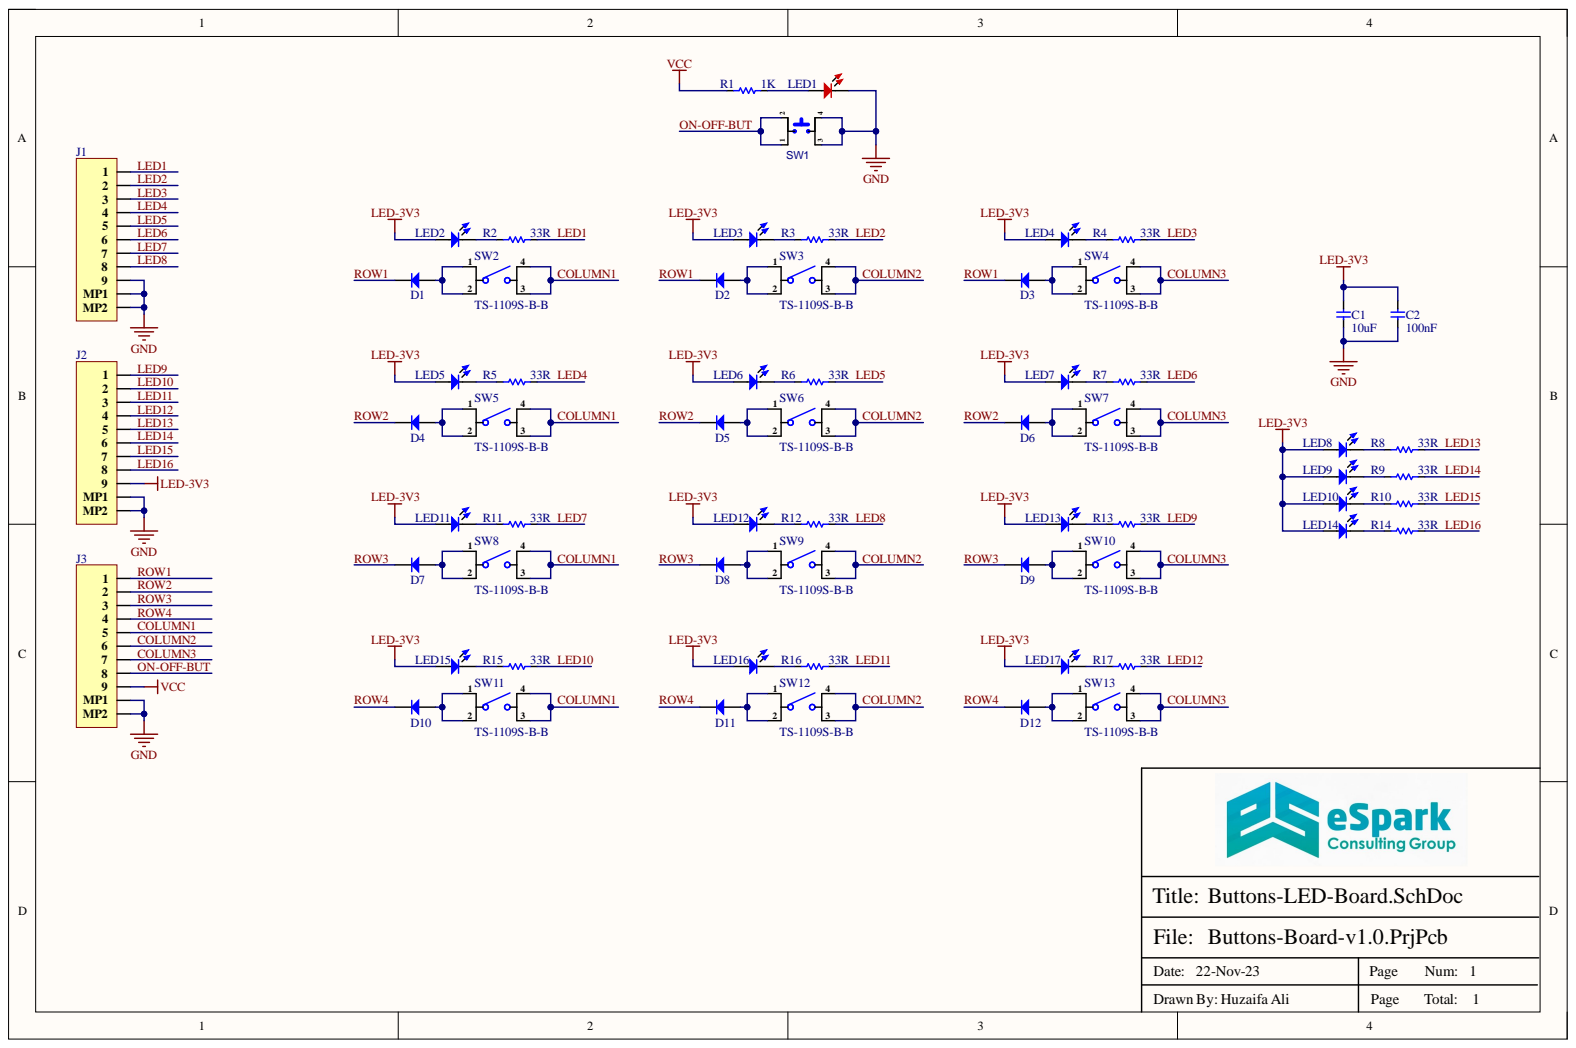
[picture p11: page 1]

Buttons-LED-Board.SchDoc

Dat e : 2 2 -N o v -2 3 | Pag e N u m : 11

D raw n B y : H uzai fa A l i | Pag e To t al :
