eSpark-Backup/simonlore-voiceassistant/(list of files, drawings)

Other design files:
Design-Files/Buttons-Board-v1.0/Buttons-Board-v1.0.PrjPcb
Design-Files/Buttons-Board-v1.0/Buttons-LED-Board.SchDoc
Design-Files/Main-Board-v1.0/Amplifier-Sheet.SchDoc
Design-Files/Main-Board-v1.0/Buttons-LED-Sheet.SchDoc
Design-Files/Main-Board-v1.0/Charging-Sheet.SchDoc
Design-Files/Main-Board-v1.0/Controller-Sheet.SchDoc
Design-Files/Main-Board-v1.0/DSP-Sheet-1.SchDoc
Design-Files/Main-Board-v1.0/DSP-Sheet-2.SchDoc
Design-Files/Main-Board-v1.0/Main-Board-v1.0.PrjPcb
Design-Files/Main-Board-v1.0/MICs-Sheet.SchDoc
Design-Files/Main-Board-v1.0/Power-Sheet.SchDoc
Design-Files/Main-Board-v1.0/SD-Card-Sheet.SchDoc
Design-Files/Main-Board-v1.0/Top-Sheet.SchDoc
Design-Files/Main-Board-v1.0/VoiceAssistant-v1.0.PcbDoc
