eSpark-Backup/simonlore-voiceassistant/(commit log)

2023-11-16 #2 Power, Charging, Controller, DSP, Amplifier, SD Card, MICs sheet added. Buttons Interfacing remaining
    [Amplifier-Sheet.SchDoc, Buttons-Sheet.SchDoc, Charging-Sheet.SchDoc, Controller-Sheet.SchDoc, DSP-Sheet-1.SchDoc, DSP-Sheet-2.SchDoc, MICs-Sheet.SchDoc, Main-Board-v1.0.PrjPcb]
2023-11-17 #2 Schematic Complete. Buttons Schematic Complete. PDF Generated. Formatting and Top Sheet Remaining
    [Amplifier-Sheet.SchDoc, Buttons-Board-v1.0.PrjPcb, Buttons-Board.SchDoc, Buttons-Sheet.SchDoc, Charging-Sheet.SchDoc, Controller-Sheet.SchDoc, DSP-Sheet-1.SchDoc, DSP-Sheet-2.SchDoc]
2023-11-22 #2 Formatting Update
    [Amplifier-Sheet.SchDoc, Buttons-Sheet.SchDoc, Charging-Sheet.SchDoc, Controller-Sheet.SchDoc, DSP-Sheet-1.SchDoc, DSP-Sheet-2.SchDoc, MICs-Sheet.SchDoc, Main-Board-v1.0.PrjPcb]
2023-11-22 #2 Sheet Renamed
    [Buttons-LED-Sheet.SchDoc, Buttons-Sheet.SchDoc, Main-Board-v1.0.PrjPcb, Power-Sheet.SchDoc]
2023-11-22 #2 16 LEDs with LED Driver Added. Complete
    [Amplifier-Sheet.SchDoc, Buttons-Board-v1.0.PrjPcb, Buttons-Board.SchDoc, Buttons-LED-Board.SchDoc, Buttons-LED-Sheet.SchDoc, Charging-Sheet.SchDoc, Controller-Sheet.SchDoc, DSP-Sheet-1.SchDoc]
2023-11-22 #2 Comment added in Amplifier-Sheet. PDF Updated
    [Amplifier-Sheet.SchDoc]
2023-11-22 #2 Git wanted to update again
    [Amplifier-Sheet.SchDoc]
2023-11-29 #2 Symbol and Footprints updated for ESP32 and SLM6600
    [Charging-Sheet.SchDoc, Controller-Sheet.SchDoc]
2023-11-29 #3 Placement in progress
    [Main-Board-v1.0.PrjPcb, VoiceAssistant-v1.0.PcbDoc]
2023-11-29 #4 eSpark BOM in progress
    [eSpark-BOM-Main-Board-v1.0.xlsx]
2023-11-30 #4 eSpark and Client BOM Added
    [Client-BOM-Buttons-Board-v1.0.xlsx, Client-BOM-Main-Board-v1.0.xlsx, eSpark-BOM-Buttons-Board-v1.0.xlsx, eSpark-BOM-Main-Board-v1.0.xlsx]
